langhz666/GD32-SmartFarm/硬件pcb/SCH_Schematic1_2026-03-23.pdf

10 10 11 11 12 12 13 13 14 14 15 15 16 16 17 17 18 18 19 19 20 20

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

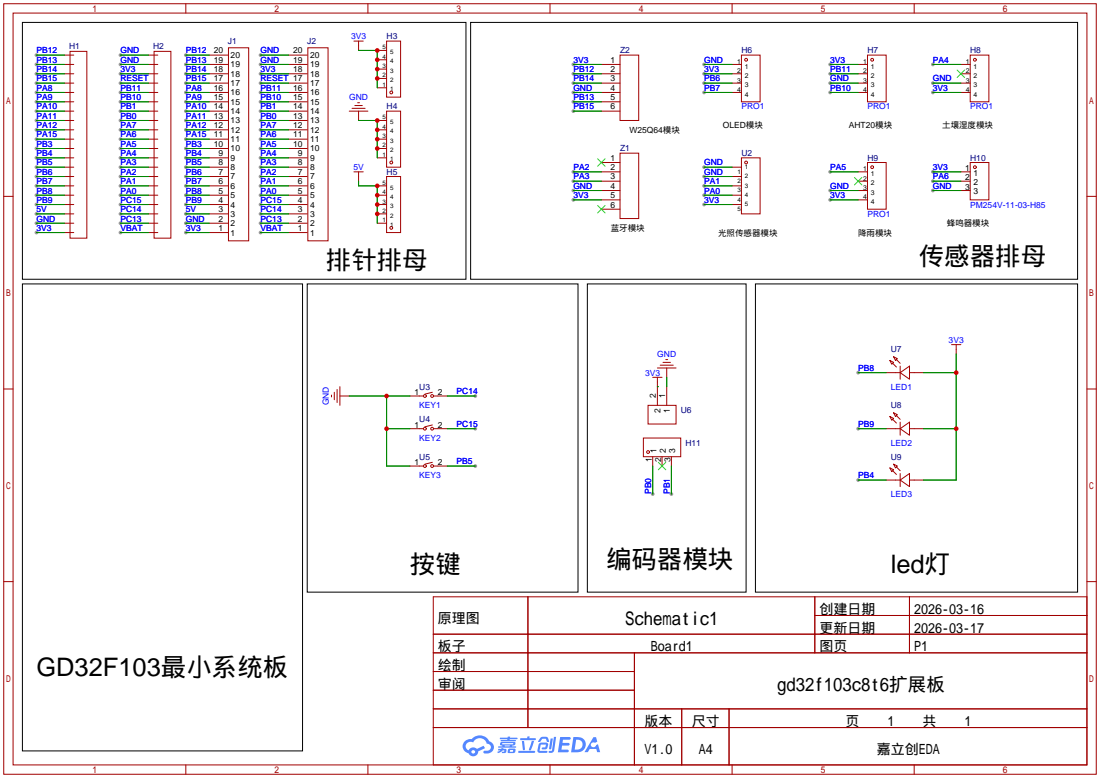
[picture p8: page 1]

原理图 | Schematic1 | 创建日期 | 2026-03-16

更新日期 | 2026-03-17

板子 | Board1 | 图页 | P1
绘制 | | gd32f103c8t6扩展板
审阅

V1.0 | A4 | 嘉立创EDA
