langhz666/GD32-SmartFarm/(list of files, drawings)

Other design files:
硬件pcb/ProPrj_gd32f103c8t6扩展板_2026-03-23.epro
