langhz666/GD32-SmartFarm/Driver/driver_oled/OLED_Data.h

#ifndef __OLED_DATA_H
#define __OLED_DATA_H

#include <stdint.h>

/*字符集定义*/
/*以下两个宏定义只可解除其中一个的注释*/
//#define OLED_CHARSET_UTF8			//定义字符集为UTF8
#define OLED_CHARSET_GB2312		//定义字符集为GB2312

/*字模基本单元*/
typedef struct 
{
	
#ifdef OLED_CHARSET_UTF8			//定义字符集为UTF8
	char Index[5];					//汉字索引，空间为5字节
#endif
	
#ifdef OLED_CHARSET_GB2312			//定义字符集为GB2312
	char Index[3];					//汉字索引，空间为3字节
#endif
	
	uint8_t Data[32];				//字模数据
} ChineseCell_t;

/*12x12汉字字模基本单元*/
typedef struct 
{
	
#ifdef OLED_CHARSET_UTF8			//定义字符集为UTF8
	char Index[5];					//汉字索引，空间为5字节
#endif
	
#ifdef OLED_CHARSET_GB2312			//定义字符集为GB2312
	char Index[3];					//汉字索引，空间为3字节
#endif
	
	uint8_t Data[24];				//字模数据（12x12 = 144位 = 18字节，但为了对齐使用24字节）
} ChineseCell12x12_t;

/*ASCII字模数据声明*/
extern const uint8_t OLED_F8x16[][16];
extern const uint8_t OLED_F6x8[][6];
extern const uint8_t OLED_F6x12[][12];

/*汉字字模数据声明*/
extern const ChineseCell_t OLED_CF16x16[];
extern const ChineseCell12x12_t OLED_CF12x12[];

/*图像数据声明*/
extern const uint8_t Diode[];
/*按照上面的格式，在这个位置加入新的图像数据声明*/
//...

#endif


/*****************江协科技|版权所有****************/
/*****************jiangxiekeji.com*****************/
