langhz666/GD32-SmartFarm/(commit log)

2026-03-09 完成light读数
2026-03-10 完成蓝牙app控制led
2026-03-11 完成雨水和土壤传感器
2026-03-12 实现ath20和bmp280
2026-03-12 解决按键问题
2026-03-12 蜂鸣器bug last
2026-03-13 解决蜂鸣器bug
2026-03-13 完成外设的编写
2026-03-13 屏幕显示bug，last
2026-03-14 屏幕显示
2026-03-14 编解码器按键bug
2026-03-14 使用key2代替旋转编码器的按键
2026-03-14 功能基本实现
2026-03-15 功能全部实现
2026-03-15 把主函数精简
2026-03-15 更新readme，移除多余文件
2026-03-15 更新演示demo
2026-03-23 feat: 修改KEY2为PB5，增加蜂鸣器警报开关功能
    - 将KEY2从PC15改为PB5，支持不同GPIO端口
    - 在主页时KEY2切换蜂鸣器警报开关
    - 在阈值页面时KEY2保持编辑模式切换功能
    - 添加PCB硬件文件和教程文档
2026-03-23 chore: 修改.gitignore允许pdf文件被提交
2026-03-23 更改按键引脚，上传pcb工程文件
    [ProPrj_gd32f103c8t6扩展板_2026-03-23.epro]
2026-03-23 docs: 添加demo2演示视频到README
2026-03-23 docs: 添加PCB板演示图片到README
2026-03-28 更新pcb工程
    [ProPrj_gd32f103c8t6扩展板_2026-03-23.epro]
